jaytlang/networkedlasers/doc/proposal/apple.jpg

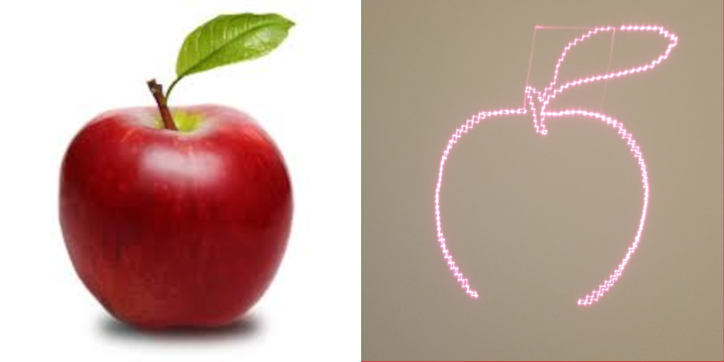
doc/proposal/apple.jpg
