jaytlang/networkedlasers/pcb/projector_board/Project Outputs for projector_board/BOM/Bill of Materials-projector_board.xlsx

Comment | Description | Designator | Fitted | Footprint | LibRef | Quantity | Value
1uF | CAP CER 1UF 16V X7R 0603 | C1, C6, C7, C13, C14, C15 |  | FP-CC0603-DA-MFG | CMP-03422-000924-1 | 6 | 1 uF
0.1uF | C0603X104K5RACTU | C2, C4, C9, C11 |  | CAPC1608X87X35NL15T15 | CMP-2006-03300-1 | 4
10uF | GRM188R60J106ME47D | C3, C5, C10, C12 |  | CAPC1608X90X35NL10T15 | CMP-2006-02792-1 | 4
4.7uF | CAP CER 4.7UF 6.3V X5R 0603 | C8 |  | FP-C0603-CG-MFG | CMP-03020-024641-1 | 1 | 4.7uF
10nF | Cap Ceramic 10nF 100V X8R 10% Pad SMD 0603 +150°C Automotive T/R | C16, C17, C18 |  | FP-CGA3E-0_3-0_1-IPC_A | CMP-08246-000769-1 | 3
BAT54HT1G | Schottky Barrier Diode, 2-Pin SOD-323, Pb-Free, Tape and Reel | D1 |  | ONSC-SOD-323-2-477-02_V | CMP-1055-00462-1 | 1
61001221121 | SMT Vertical Pin Header WR-PHD, Pitch 2.54 mm, Dual Row, 12 pins | J1 |  | 61001221121 | CMP-1502-01029-1 | 1
61300411121 | THT Vertical Pin Header WR-PHD, Pitch 2.54 mm, Single Row, 4 pins | P1 |  | 61300411121 | CMP-1502-01064-1 | 1
Blue | Male Header, Pitch 2.5 mm, 1 x 2 Position, Height 7 mm, Tail Length 3.4 mm, -25 to 85 degC, RoHS, Bulk | P2 |  | JST-B2B-XH-A_V | CMP-2000-05888-1 | 1
Green | Male Header, Pitch 2.5 mm, 1 x 2 Position, Height 7 mm, Tail Length 3.4 mm, -25 to 85 degC, RoHS, Bulk | P3 |  | JST-B2B-XH-A_V | CMP-2000-05888-1 | 1
Red | Male Header, Pitch 2.5 mm, 1 x 2 Position, Height 7 mm, Tail Length 3.4 mm, -25 to 85 degC, RoHS, Bulk | P4 |  | JST-B2B-XH-A_V | CMP-2000-05888-1 | 1
+15V | Male Header, Pitch 2.5 mm, 1 x 2 Position, Height 7 mm, Tail Length 3.4 mm, -25 to 85 degC, RoHS, Bulk | P5 |  | JST-B2B-XH-A_V | CMP-2000-05888-1 | 1
50C02MH-TL-E | Bipolar Transistor, 50 V, 0.5 A, Low VCE(sat), NPN Single, 3-Pin MCPH, Pb-Free, Tape and Reel | Q1, Q2, Q3 |  | ONSC-MCPH-3_V | CMP-1048-00258-1 | 3
10K | Chip Resistor, 10 KOhm, +/- 1%, 0.1 W, -55 to 155 degC, 0603 (1608 Metric), RoHS, Tape and Reel | R1, R2, R6, R7, R8 |  | RESC1609X55X30LL15T15 | CMP-2000-07452-1 | 5
10K | Trimming Potentiometer, 10 KOhm, -55 to 125 degC, 3-Pin SMD, RoHS, Tape and Reel | R3, R4, R5 |  | BOUR-3313J-1_V | CMP-2000-05585-1 | 3
127R | ERJ-3EKF1270V | R9, R10, R11 |  | RESC1608X55X30LL15T15 | CMP-2000-00226-1 | 3
AD5541ABRMZ | Single 16-Bit Voltage Output Digital-to-Analog Converter with Serial Interface, 2.7 to 5.5 V, -40 to +125 degC, RM-10, Pb-Free, Tube | U1, U3 |  | RM-10_L | CMP-0318-02105-2 | 2
AD8605ARTZ-REEL7 | Single Channel Wide Bandwidth Operational Amplifier, 10 MHz BW, 5 V/us SR, Industrial, 5-pin SOT23 (RJ-5), Reel | U2, U5, U6, U7, U8 |  | ADI-RJ-5_M | CMP-0384-01494-2 | 5
AD1582BRTZ-REEL7 | Micropower, Precision Series Mode Voltage Reference, 2.5 V Output, 2.7 to 12 V Supply, Industrial, 3-pin SOT23 (RT-3), Reel | U4 |  | ADI-RT-3_M | CMP-0784-00464-1 | 1
