jaytlang/networkedlasers/pcb/projector_board/Project Outputs for projector_board/ExportSTEP/projector_board.step

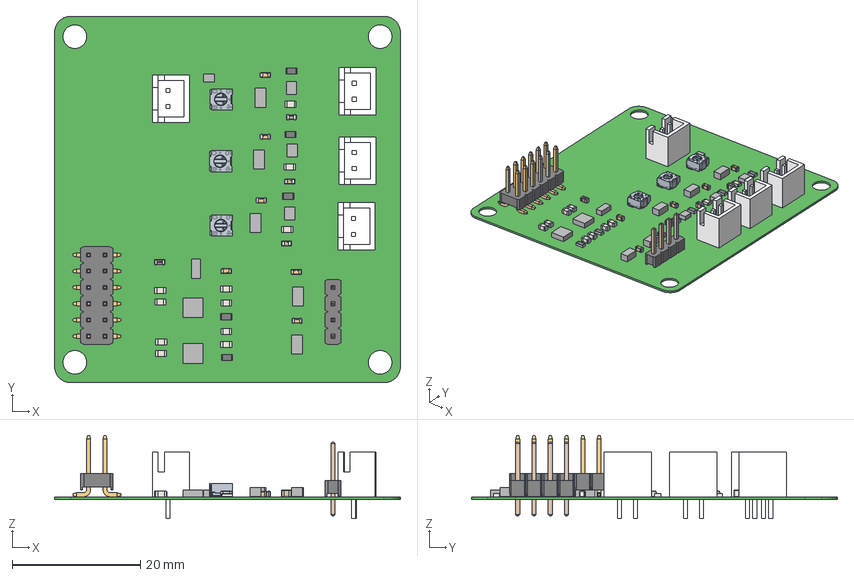
[picture p4: CAD file, 2020-11-20]
pcb/projector_board/Project Outputs for projector_board/ExportSTEP/projector_board.step
54.0 x 57.2 x 13.0 mm
Extruded x 45
6100xx21121_PIN x 12
B2B-XH-A_RGB16777215 x 4
Mid_Body x 5
Open_CASCADE_STEP_translator_6.8_1.2.1 x 10
Mark x 5
3313J-001 x 3
TDK_Logo x 3
name x 6
KEMET
6130xx11121_PIN x 4
