jaytlang/networkedlasers/pcb/projector_board/schematic.pdf

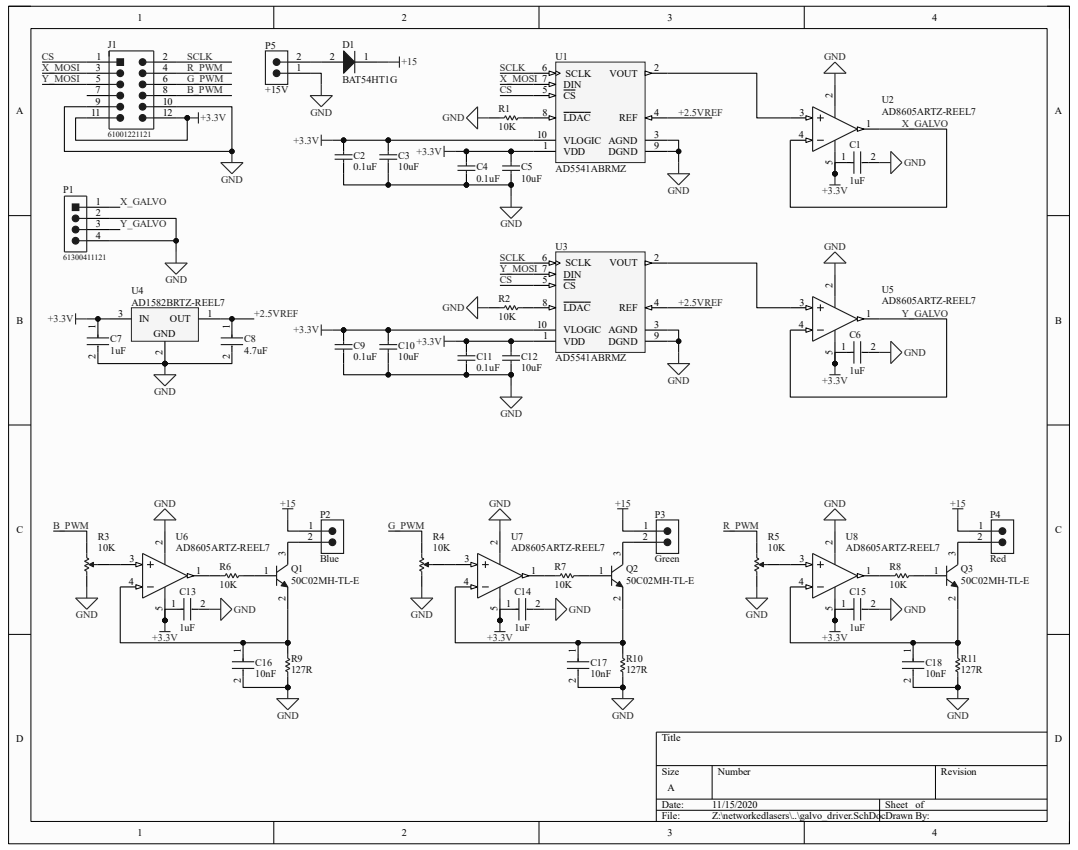
[picture p5: page 1]
