jaytlang/networkedlasers/(list of files, drawings)

Other design files:
pcb/projector_board/galvo_driver.SchDoc
pcb/projector_board/projector_board.PcbDoc
pcb/projector_board/projector_board.PrjPcb
