jaytlang/networkedlasers/(commit log)

2020-11-13 Create Ethernet branch
    Modify the README to indicate this is an early-dev branch
    for Ethernet, where changes should get to master eventually
    once they are integrated with the laser side.
2020-11-13 Update branch with latest networking code, deflated project
    Add a simple L2 echo server to source control. Given a MAC packet
    with ambiguous data, echo back this data with the source/dest
    MAC addresses flipped. Calculate the CRC in full, but leave
    padding packet data to the hardware after experimental verification
    shows this works for the Nexys's chip. Implement clean interfaces
    for these functionalities so that they be used for higher level
    internet protocols.
    Modify the .gitignore extensively to block generated IP, the vivado
    project from ever getting pushed to the remote.
    [crc32_bzip2.sv, ethernet_nexys4_ddr.xdc, mac_rx.sv, mac_rx_ifc.sv, mac_tx.sv, mac_tx_ifc.sv]
2020-11-13 Create laser branch
    Modify the README accordingly. Fischer, this is all you!
2020-11-14 regenerate vivado_generate.tcl
    [Schlib1.SchLib]
2020-11-14 schematic for laser driver done
    [Schlib1.SchLib, galvo_driver.SchDoc, laser_driver.SchDoc]
2020-11-15 finish galvo schematic, add board
    [galvo_driver.SchDoc, laser_driver.SchDoc, projector_board.PcbDoc, projector_board.PrjPcb]
2020-11-15 Patch Ethernet to utilize non-incidental padding
    An earlier version of Ethernet relied upon the fact that incoming
    packets were padded, so echoing didn't require a pad in order
    to function properly. Verify the functionality of padding and
    add it back in.
    [mac_tx.sv]
2020-11-15 finished layout of galvo section
    [galvo_driver.SchDoc, laser_driver.SchDoc, projector_board.PcbDoc]
2020-11-15 Implement broadcast reception for the MAC receiver
    The MAC is selective about what addresses it allows packets
    sent to, i.e. "promiscuous mode" is always disabled on our device.
    However, the broadcast address is now recognized, which will be
    critical for technologies like ARP to work.
2020-11-15 commit before nuking laser dacs
    [galvo_driver.SchDoc, laser_driver.SchDoc, projector_board.PcbDoc]
2020-11-16 board done
    [galvo_driver.SchDoc, laser_driver.SchDoc, projector_board.PcbDoc, projector_board.PrjPcb]
2020-11-16 was just kidding before, board is now actually done
    [galvo_driver.SchDoc, projector_board.PcbDoc, projector_board.PrjPcb]
2020-11-16 add gerbers
    [Assembly Testpoint Report for projector_board.csv, Bill of Materials-projector_board.xlsx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]
2020-11-16 change rgb to pwm driver instead of dac driver
2020-11-16 add frame sync for easy pwm testing
2020-11-17 added command line args opts to laser preprocessor, unified scripts
2020-11-17 Add whitespace removal script, because why not
    Just operate on *.sv files for now, to avoid accidentally
    borking any verilog project files if that's active.
    [crc32_bzip2.sv, mac_rx.sv, mac_rx_ifc.sv, mac_tx.sv, mac_tx_ifc.sv]
2020-11-17 Patch hdl/net_top.sv, first ARP pass
    Adhere to whitespace removal via a fast merge, and write a first
    pass at ARP. This is currently untested; verify C functions via
    internal testing before attempting to test on the FPGA.
2020-11-17 Switch back to packed logic, diagnose etype recognition issues
    The Ethertype is currently not being recognized properly, even though
    CRC is verified appropriately from within the MAC interface. Start
    the process of debugging this.
    Additionally, find that using 2D packed arrays == using unpacked/packed
    combo in terms of LUT usage. The difference is only a typing-related
    one. Make this fix across modules and ensure compilation works.
    [mac_rx_ifc.sv, mac_tx_ifc.sv]
2020-11-18 add scapy to laser.py
2020-11-19 Pre-integration, perform thorough indexing and continue diagnosis
    Make a series of changes to indexing such that it is performed
    per byte, ensuring any errors in 2D array accesses are obviated.
    I've been working so long on this...
    [mac_tx_ifc.sv]
2020-11-19 Fix a nasty bug causing incorrect CRC math on ~1/4 of outgoing packets
    The CRC is_calculation_cycle flag in hdl/mac_tx.sv was incorrectly
    being deasserted. This allowed for small packets to pass through
    OK, owing to padding, but some larger ones fail. After extensive
    testing, fix the issue and tweak testing regimen to test
    for integrity of these larger packets.
    [mac_tx.sv, mac_tx_ifc.sv]
2020-11-20 Implement Address Resolution Protocol Version 4
    ARPv4 resps have been shown to work -- remains to be seen whether
    the IP logic will be able to marshal out requests properly while
    maintaining proper buffering, and also a degree of simplicity.
    Perhaps the implementation of a state machine - y fastpath will
    work out.
    Nits: fix a bug in the data counter of the transmission module.
    [mac_rx_ifc.sv, mac_tx.sv]
2020-11-23 Implement UDP and connect system to open internet
    Implement a full UDP stack without ICMP listening over
    port 0xA455 for data in, and then relay information
    to the top level. A combination of this + ARP renders
    the system self sufficient; i.e. it can be plugged into
    a router and accessed from the open internet.
    Implement a refined error analysis mechanism through
    the LED readout. Reference include/errno.svh to see
    what readouts mean. I hardly use the upper 8 LEDs; perhaps
    these can be repurposed for laser projector diagnostics
    if this is deemed necessary.
    Fully implement the IPv4 reception subsystem, including
    the variable length header checksum. This should compute
    within the requisite ti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
    [ipv4_csum.sv, netstack.sv, sys_top.sv]
2020-11-24 fix framebuffer, frame streaming is now possible with L2 network
    [display_controller.sv, display_controller_tb.sv, ethernet_nexys4_ddr.xdc, hex_display.sv]
2020-12-07 fix image processing for higher framerate
    [display_controller.sv, pwm.sv]
2020-12-08 Integrate UDP module with display controller
    Using Fischer's display controller from the master branch,
    attach the L4 network stack to the laser module and fix bugs
    surrounding the obviated need for offsets in packet buffers.
    Additionally, tweak the gitignore so it can now accept block
    memory, and add debugging mechanisms (example ILAs, the hex
    display, etc.)
    This completes the project, pending a move to the master
    branch.
    [display_controller.sv, ethernet_nexys4_ddr.xdc, hex_display.sv, netstack.sv, pwm.sv, spi.sv, sys_top.sv]
2020-12-08 Nits: fix XDC file to include LEDs
    The master XDC file was written for MAC development,
    and didn't include the rather extensive stuff I used on the LED
    side for debugging. Get this back and uncomment properly.
    [ethernet_nexys4_ddr.xdc]
2020-12-08 Nits: fix board pinout to what's actually going down in the box
    The laser projector box uses JD, even though we used JC for
    debugging. Make this switch so that the closed system runs
    properly.
    [sys_top.sv]
